MILOUDIAS/RFID8549_PCB/README.md

# RFID8549_PCB
PCB for bring-up testing of our RFID chip in ihp sg13g2 pdk
