MILOUDIAS/RFID8549_PCB/rfid8549_testboard_bom.csv

Refs | Value | Footprint | Qty | DNP
C1,C4,C6 | 10u | Capacitor_SMD:C_1206_3216Metric | 3
C2,C3,C5,C7,C9 | 100n | Capacitor_SMD:C_0805_2012Metric | 5
C8 | 10n | Capacitor_SMD:C_0805_2012Metric | 1
H1-H4 | M3 | MountingHole:MountingHole_3.2mm_M3_Pad_Via | 4
J1 | BENCH SUPPLIES | TerminalBlock_Phoenix:TerminalBlock_Phoenix_MKDS-1,5-6_1x06_P5.00mm_Horizontal | 1
J2 | ESP32-C3 JIG | Connector_PinHeader_2.54mm:PinHeader_2x06_P2.54mm_Vertical | 1
J3 | COIL | TerminalBlock_Phoenix:TerminalBlock_Phoenix_MKDS-1,5-2_1x02_P5.00mm_Horizontal | 1
J4 | VREF IN | Connector_PinHeader_2.54mm:PinHeader_1x02_P2.54mm_Vertical | 1
J5 | CE_AC1 IN | Connector_Coaxial:SMA_Amphenol_132134_Vertical | 1
J6 | CE_AC2 IN | Connector_Coaxial:SMA_Amphenol_132134_Vertical | 1
J7 | CLK IN | Connector_Coaxial:SMA_Amphenol_132134_Vertical | 1
JP1 | CLK_IN SRC | Connector_PinHeader_2.54mm:PinHeader_1x03_P2.54mm_Vertical | 1
JP2 | RESET_N SRC | Connector_PinHeader_2.54mm:PinHeader_1x03_P2.54mm_Vertical | 1
JP3 | POWER SRC | Connector_PinHeader_2.54mm:PinHeader_1x03_P2.54mm_Vertical | 1
JP4 | MOD LOOP | Connector_PinHeader_2.54mm:PinHeader_1x02_P2.54mm_Vertical | 1
JP5 | CE_AC1 SRC | Connector_PinHeader_2.54mm:PinHeader_1x03_P2.54mm_Vertical | 1
JP6 | CE_AC2 SRC | Connector_PinHeader_2.54mm:PinHeader_1x03_P2.54mm_Vertical | 1
JP7 | AVDD SRC | Connector_PinHeader_2.54mm:PinHeader_1x03_P2.54mm_Vertical | 1
JP8 | DVDD SRC | Connector_PinHeader_2.54mm:PinHeader_1x03_P2.54mm_Vertical | 1
JP9 | VREF SRC | Connector_PinHeader_2.54mm:PinHeader_1x03_P2.54mm_Vertical | 1
JP10 | I IOVDD | Connector_PinHeader_2.54mm:PinHeader_1x02_P2.54mm_Vertical | 1
JP11 | I DVDD | Connector_PinHeader_2.54mm:PinHeader_1x02_P2.54mm_Vertical | 1
JP12 | I AVDD | Connector_PinHeader_2.54mm:PinHeader_1x02_P2.54mm_Vertical | 1
R1-R8 | 33 | Resistor_SMD:R_0805_2012Metric | 8
R9 | 2k2 | Resistor_SMD:R_0805_2012Metric | 1
R10,R14 | 10k | Resistor_SMD:R_0805_2012Metric | 2
R11-R13 | 100k | Resistor_SMD:R_0805_2012Metric | 3
R15 | 15k | Resistor_SMD:R_0805_2012Metric | 1
RV1 | 10k | Potentiometer_THT:Potentiometer_Bourns_3296W_Vertical | 1
TP1 | IOVDD | TestPoint:TestPoint_Keystone_5000-5004_Miniature | 1
TP2 | DVDD | TestPoint:TestPoint_Keystone_5000-5004_Miniature | 1
TP3 | AVDD | TestPoint:TestPoint_Keystone_5000-5004_Miniature | 1
TP4 | V_RECT | TestPoint:TestPoint_Keystone_5000-5004_Miniature | 1
TP5 | LDO1_OUT | TestPoint:TestPoint_Keystone_5000-5004_Miniature | 1
TP6 | LDO1_VREF | TestPoint:TestPoint_Keystone_5000-5004_Miniature | 1
TP7 | LDO2_OUT | TestPoint:TestPoint_Keystone_5000-5004_Miniature | 1
TP8 | BGR_OUT | TestPoint:TestPoint_Keystone_5000-5004_Miniature | 1
TP9 | AC1 | TestPoint:TestPoint_Keystone_5000-5004_Miniature | 1
TP10 | AC2 | TestPoint:TestPoint_Keystone_5000-5004_Miniature | 1
TP11 | CE_AC1 | TestPoint:TestPoint_Keystone_5000-5004_Miniature | 1
TP12 | CE_AC2 | TestPoint:TestPoint_Keystone_5000-5004_Miniature | 1
TP13 | CLK_OUT | TestPoint:TestPoint_Keystone_5000-5004_Miniature | 1
TP14 | RESET_N_OUT | TestPoint:TestPoint_Keystone_5000-5004_Miniature | 1
TP15 | POWER_STABLE_OUT | TestPoint:TestPoint_Keystone_5000-5004_Miniature | 1
TP16 | CLK_IN | TestPoint:TestPoint_Keystone_5000-5004_Miniature | 1
TP17 | RESET_N_IN | TestPoint:TestPoint_Keystone_5000-5004_Miniature | 1
TP18 | POWER_STABLE_IN | TestPoint:TestPoint_Keystone_5000-5004_Miniature | 1
TP19 | MODULATED_BIT_OUT | TestPoint:TestPoint_Keystone_5000-5004_Miniature | 1
TP20 | MODULATED_BIT_IN | TestPoint:TestPoint_Keystone_5000-5004_Miniature | 1
TP21 | SPI_SCK | TestPoint:TestPoint_Keystone_5000-5004_Miniature | 1
TP22 | SPI_CS_N | TestPoint:TestPoint_Keystone_5000-5004_Miniature | 1
TP23 | SPI_MOSI | TestPoint:TestPoint_Keystone_5000-5004_Miniature | 1
TP24 | SPI_MISO | TestPoint:TestPoint_Keystone_5000-5004_Miniature | 1
TP25-TP28 | GND | TestPoint:TestPoint_Keystone_5000-5004_Miniature | 4
U1 | RFID8549 | Package_DFN_QFN:QFN-28-1EP_5x5mm_P0.5mm_EP3.35x3.35mm_ThermalVias | 1
