MILOUDIAS/RFID8549_PCB/rfid8549_testboard.kicad_pcb

## KiCad design rfid8549_testboard.kicad_pcb (2026-11-05)

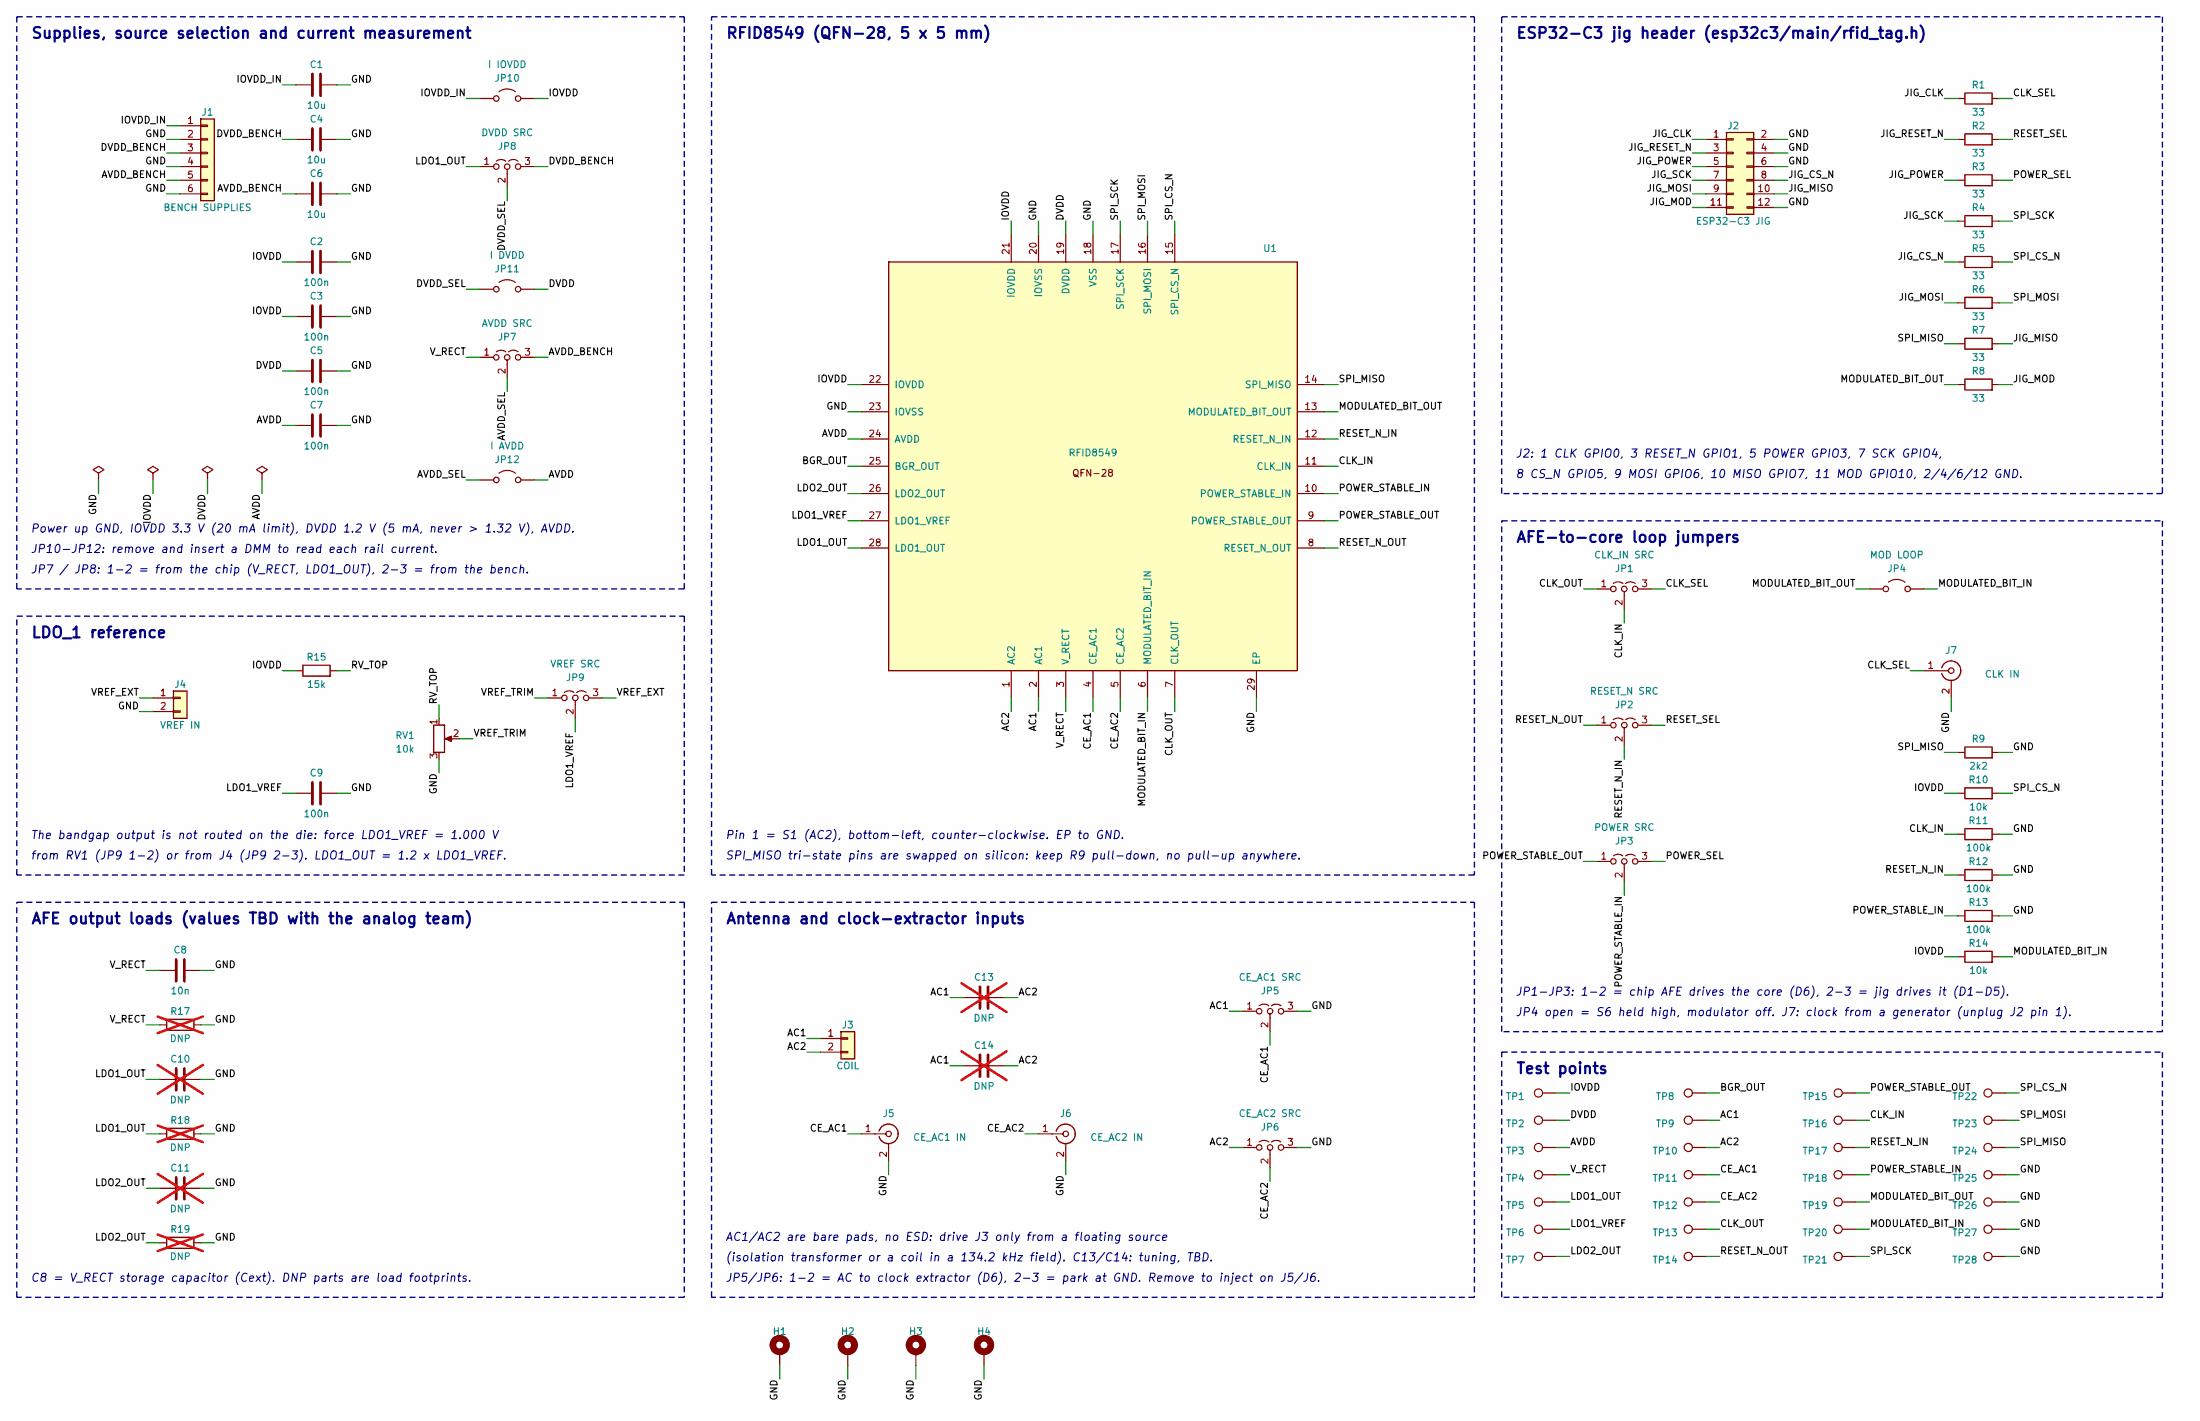
[picture p2: schematic rfid8549_testboard.kicad_sch, RFID8549 test board]

Parts:
C1, C4, C6: 10u; C_1206_3216Metric
C2, C3, C5, C7, C9: 100n; C_0805_2012Metric
C8: 10n; C_0805_2012Metric
C10, C11, C13, C14: DNP; C_0805_2012Metric; not fitted
H1, H2, H3, H4: M3; MountingHole_3.2mm_M3_Pad_Via
J1: BENCH SUPPLIES; TerminalBlock_Phoenix_MKDS-1,5-6_1x06_P5.00mm_Horizontal
J2: ESP32-C3 JIG; PinHeader_2x06_P2.54mm_Vertical
J3: COIL; TerminalBlock_Phoenix_MKDS-1,5-2_1x02_P5.00mm_Horizontal
J4: VREF IN; PinHeader_1x02_P2.54mm_Vertical
J5: CE_AC1 IN; SMA_Amphenol_132134_Vertical
J6: CE_AC2 IN; SMA_Amphenol_132134_Vertical
J7: CLK IN; SMA_Amphenol_132134_Vertical
JP1: CLK_IN SRC; PinHeader_1x03_P2.54mm_Vertical
JP2: RESET_N SRC; PinHeader_1x03_P2.54mm_Vertical
JP3: POWER SRC; PinHeader_1x03_P2.54mm_Vertical
JP4: MOD LOOP; PinHeader_1x02_P2.54mm_Vertical
JP5: CE_AC1 SRC; PinHeader_1x03_P2.54mm_Vertical
JP6: CE_AC2 SRC; PinHeader_1x03_P2.54mm_Vertical
JP7: AVDD SRC; PinHeader_1x03_P2.54mm_Vertical
JP8: DVDD SRC; PinHeader_1x03_P2.54mm_Vertical
JP9: VREF SRC; PinHeader_1x03_P2.54mm_Vertical
JP10: I IOVDD; PinHeader_1x02_P2.54mm_Vertical
JP11: I DVDD; PinHeader_1x02_P2.54mm_Vertical
JP12: I AVDD; PinHeader_1x02_P2.54mm_Vertical
R1, R2, R3, R4, R5, R6, R7, R8: 33; R_0805_2012Metric
R9: 2k2; R_0805_2012Metric
R10, R14: 10k; R_0805_2012Metric
R11, R12, R13: 100k; R_0805_2012Metric
R15: 15k; R_0805_2012Metric
R17, R18, R19: DNP; R_0805_2012Metric; not fitted
RV1: 10k; Potentiometer_Bourns_3296W_Vertical
TP1: IOVDD; TestPoint_Keystone_5000-5004_Miniature
TP2: DVDD; TestPoint_Keystone_5000-5004_Miniature
TP3: AVDD; TestPoint_Keystone_5000-5004_Miniature
TP4: V_RECT; TestPoint_Keystone_5000-5004_Miniature
TP5: LDO1_OUT; TestPoint_Keystone_5000-5004_Miniature
TP6: LDO1_VREF; TestPoint_Keystone_5000-5004_Miniature
TP7: LDO2_OUT; TestPoint_Keystone_5000-5004_Miniature
TP8: BGR_OUT; TestPoint_Keystone_5000-5004_Miniature
TP9: AC1; TestPoint_Keystone_5000-5004_Miniature
TP10: AC2; TestPoint_Keystone_5000-5004_Miniature
TP11: CE_AC1; TestPoint_Keystone_5000-5004_Miniature
TP12: CE_AC2; TestPoint_Keystone_5000-5004_Miniature
TP13: CLK_OUT; TestPoint_Keystone_5000-5004_Miniature
TP14: RESET_N_OUT; TestPoint_Keystone_5000-5004_Miniature
TP15: POWER_STABLE_OUT; TestPoint_Keystone_5000-5004_Miniature
TP16: CLK_IN; TestPoint_Keystone_5000-5004_Miniature
TP17: RESET_N_IN; TestPoint_Keystone_5000-5004_Miniature
TP18: POWER_STABLE_IN; TestPoint_Keystone_5000-5004_Miniature
TP19: MODULATED_BIT_OUT; TestPoint_Keystone_5000-5004_Miniature
TP20: MODULATED_BIT_IN; TestPoint_Keystone_5000-5004_Miniature
TP21: SPI_SCK; TestPoint_Keystone_5000-5004_Miniature
TP22: SPI_CS_N; TestPoint_Keystone_5000-5004_Miniature
TP23: SPI_MOSI; TestPoint_Keystone_5000-5004_Miniature
TP24: SPI_MISO; TestPoint_Keystone_5000-5004_Miniature
TP25, TP26, TP27, TP28: GND; TestPoint_Keystone_5000-5004_Miniature
U1: RFID8549; QFN-28-1EP_5x5mm_P0.5mm_EP3.35x3.35mm_ThermalVias

Connections:
AC1: C13.1, C14.1, J3.1, JP5.1 (A), TP9.1, U1.2 (AC1)
AC2: C13.2, C14.2, J3.2, JP6.1 (A), TP10.1, U1.1 (AC2)
AVDD: C7.1, JP12.2 (B), TP3.1, U1.24 (AVDD)
AVDD_BENCH: C6.1, J1.5, JP7.3 (B)
AVDD_SEL: JP7.2 (C), JP12.1 (A)
BGR_OUT: TP8.1, U1.25 (BGR_OUT)
CE_AC1: J5.1 (In), JP5.2 (C), TP11.1, U1.4 (CE_AC1)
CE_AC2: J6.1 (In), JP6.2 (C), TP12.1, U1.5 (CE_AC2)
CLK_IN: JP1.2 (C), R11.1, TP16.1, U1.11 (CLK_IN)
CLK_OUT: JP1.1 (A), TP13.1, U1.7 (CLK_OUT)
CLK_SEL: J7.1 (In), JP1.3 (B), R1.2
DVDD: C5.1, JP11.2 (B), TP2.1, U1.19 (DVDD)
DVDD_BENCH: C4.1, J1.3, JP8.3 (B)
DVDD_SEL: JP8.2 (C), JP11.1 (A)
GND: C1.2, C2.2, C3.2, C4.2, C5.2, C6.2, C7.2, C8.2, C9.2, C10.2, C11.2, H1.1, H2.1, H3.1, H4.1, J1.2, J1.4, J1.6, J2.2, J2.4, J2.6, J2.12, J4.2, J5.2 (Ext), J6.2 (Ext), J7.2 (Ext), JP5.3 (B), JP6.3 (B), R9.2, R11.2, R12.2, R13.2, R17.2, R18.2, R19.2, RV1.3, TP25.1, TP26.1, TP27.1, TP28.1, U1.18 (VSS), U1.20 (IOVSS), U1.23 (IOVSS), U1.29 (EP)
IOVDD: C2.1, C3.1, JP10.2 (B), R10.1, R14.1, R15.1, TP1.1, U1.21 (IOVDD), U1.22 (IOVDD)
IOVDD_IN: C1.1, J1.1, JP10.1 (A)
JIG_CLK: J2.1, R1.1
JIG_CS_N: J2.8, R5.1
JIG_MISO: J2.10, R7.2
JIG_MOD: J2.11, R8.2
JIG_MOSI: J2.9, R6.1
JIG_POWER: J2.5, R3.1
JIG_RESET_N: J2.3, R2.1
JIG_SCK: J2.7, R4.1
LDO1_OUT: C10.1, JP8.1 (A), R18.1, TP5.1, U1.28 (LDO1_OUT)
LDO1_VREF: C9.1, JP9.2 (C), TP6.1, U1.27 (LDO1_VREF)
LDO2_OUT: C11.1, R19.1, TP7.1, U1.26 (LDO2_OUT)
MODULATED_BIT_IN: JP4.2 (B), R14.2, TP20.1, U1.6 (MODULATED_BIT_IN)
MODULATED_BIT_OUT: JP4.1 (A), R8.1, TP19.1, U1.13 (MODULATED_BIT_OUT)
POWER_SEL: JP3.3 (B), R3.2
POWER_STABLE_IN: JP3.2 (C), R13.1, TP18.1, U1.10 (POWER_STABLE_IN)
POWER_STABLE_OUT: JP3.1 (A), TP15.1, U1.9 (POWER_STABLE_OUT)
RESET_N_IN: JP2.2 (C), R12.1, TP17.1, U1.12 (RESET_N_IN)
RESET_N_OUT: JP2.1 (A), TP14.1, U1.8 (RESET_N_OUT)
RESET_SEL: JP2.3 (B), R2.2
RV_TOP: R15.2, RV1.1
SPI_CS_N: R5.2, R10.2, TP22.1, U1.15 (SPI_CS_N)
SPI_MISO: R7.1, R9.1, TP24.1, U1.14 (SPI_MISO)
SPI_MOSI: R6.2, TP23.1, U1.16 (SPI_MOSI)
SPI_SCK: R4.2, TP21.1, U1.17 (SPI_SCK)
VREF_EXT: J4.1, JP9.3 (B)
VREF_TRIM: JP9.1 (A), RV1.2
V_RECT: C8.1, JP7.1 (A), R17.1, TP4.1, U1.3 (V_RECT)

Notes on the sheet:
Supplies, source selection and current measurement
Power up GND, IOVDD 3.3 V (20 mA limit), DVDD 1.2 V (5 mA, never > 1.32 V), AVDD.
JP10-JP12: remove and insert a DMM to read each rail current.
JP7 / JP8: 1-2 = from the chip (V_RECT, LDO1_OUT), 2-3 = from the bench.
LDO_1 reference
The bandgap output is not routed on the die: force LDO1_VREF = 1.000 V
from RV1 (JP9 1-2) or from J4 (JP9 2-3). LDO1_OUT = 1.2 x LDO1_VREF.
AFE output loads (values TBD with the analog team)
C8 = V_RECT storage capacitor (Cext). DNP parts are load footprints.
RFID8549 (QFN-28, 5 x 5 mm)
Pin 1 = S1 (AC2), bottom-left, counter-clockwise. EP to GND.
SPI_MISO tri-state pins are swapped on silicon: keep R9 pull-down, no pull-up anywhere.
Antenna and clock-extractor inputs
AC1/AC2 are bare pads, no ESD: drive J3 only from a floating source
(isolation transformer or a coil in a 134.2 kHz field). C13/C14: tuning, TBD.
JP5/JP6: 1-2 = AC to clock extractor (D6), 2-3 = park at GND. Remove to inject on J5/J6.
ESP32-C3 jig header (esp32c3/main/rfid_tag.h)
J2: 1 CLK GPIO0, 3 RESET_N GPIO1, 5 POWER GPIO3, 7 SCK GPIO4,
8 CS_N GPIO5, 9 MOSI GPIO6, 10 MISO GPIO7, 11 MOD GPIO10, 2/4/6/12 GND.
AFE-to-core loop jumpers
JP1-JP3: 1-2 = chip AFE drives the core (D6), 2-3 = jig drives it (D1-D5).
JP4 open = S6 held high, modulator off. J7: clock from a generator (unplug J2 pin 1).
Test points

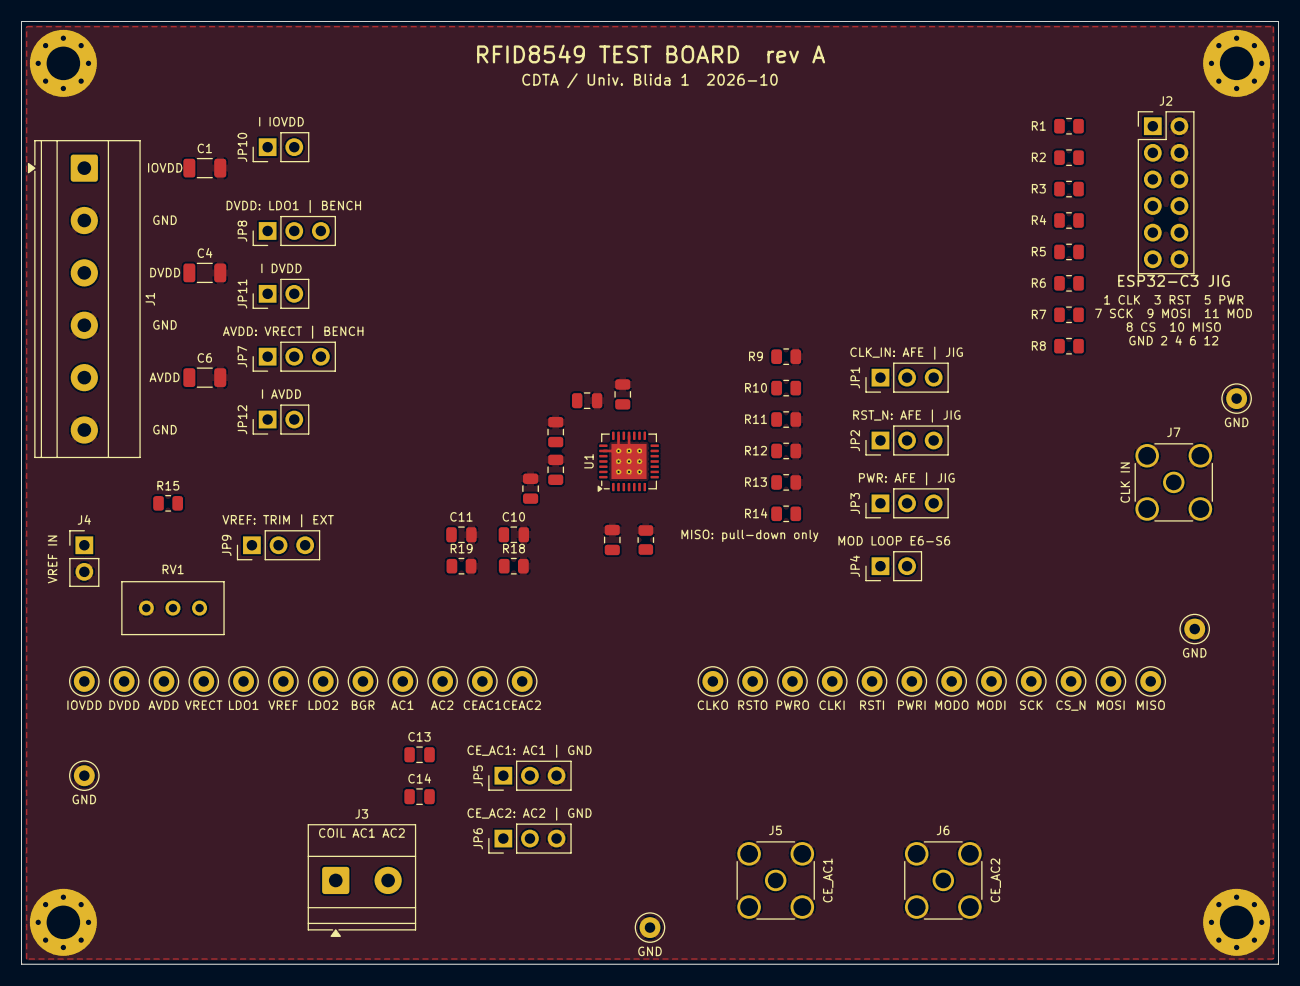
[picture p3: board rfid8549_testboard.kicad_pcb from above]

Board: 2 copper layers, 120.0 x 90.0 mm, 84 parts (0 on the bottom side), 44 nets.
